stevendiemer/Project-326/README.txt

Hello! 

Thanks for downloading our files! If you have any 
comments or concerns, please let us know by e-mailing 
us at steven.diemer23@gmail.com. 

- Downloading Eagle Schematic and Layout 
	- Say "Open With" 
	- Find Eagle.exe 

Thanks, 

Steven Diemer 
Jordan Visser
