stevendiemer/Project-326/Presentation/Design Review.pptx

## -Design Review- Wave-Motion Arduino Shield

Presented By: Jordan Visser & Steven Diemer
EGR 326: Embedded System Design
Instructor: Andrew Sterian

## Slide 2

Project Summary
Design and Market an Arduino Shield

Project Scope

What is an Arduino?

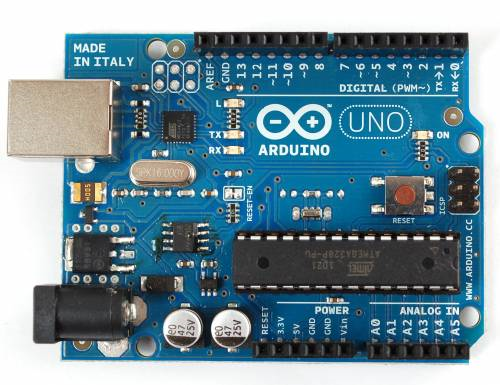
[picture p8: figure]

What is an Arduino Shield?

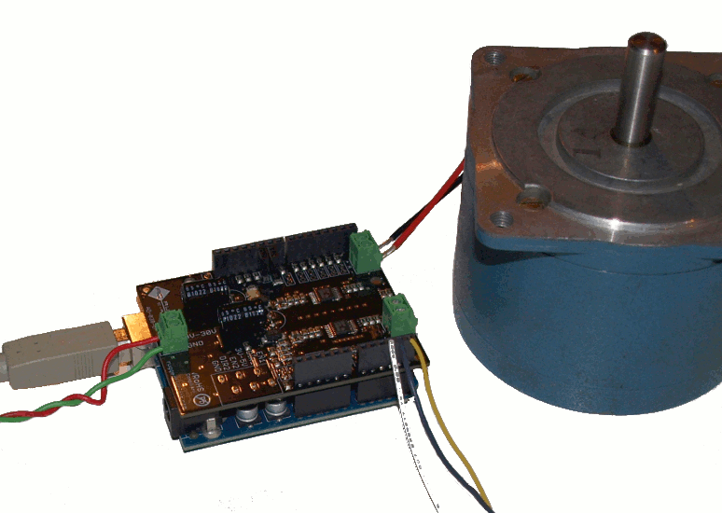
[picture p9: figure]

## Slide 3

Project Motivation

What is it that we are building?

Wanted to build something that…

  - Is fun and also “hackable”/expandable

  - Provided an opportunity to become familiar in many areas we have not previously been exposed to

Why are we building it?

Flash Memory

DAC

Accelerometer

Speaker & Microphone (Audio Capture/Playback)

## Slide 4

Wave-Motion vs. Existing Products

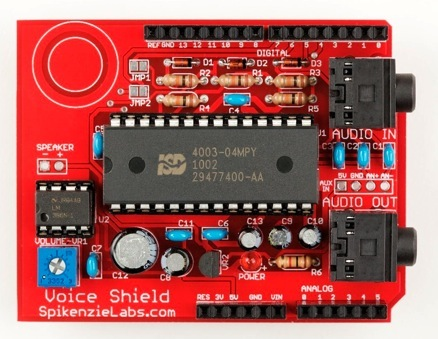
[picture p10: figure]

SpikenzieLabs Voice Shield

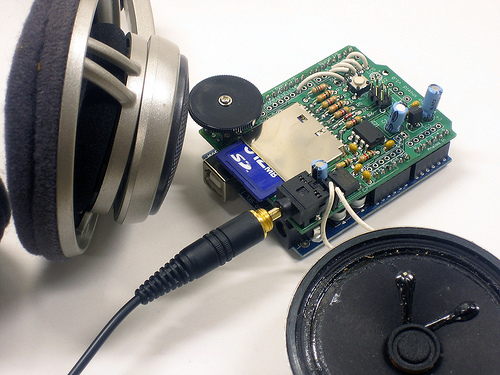
[picture p11: figure]

Ladyada Wave Shield

## Slide 5

Functional Requirements

1. 120 seconds of audio storage at 10-bit 16KHz sampling
rate (minimum)

2) 10-bit 16KHz recording/playback (with no re-sampling)

3) (+/- 8g) 3-Axis Accelerometer Controlled Playback

## Slide 6

Wave-Motion Flow Chart

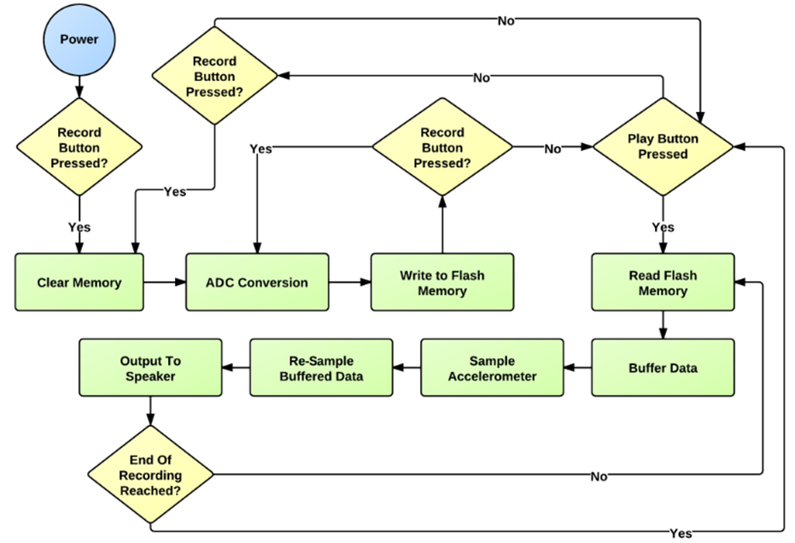
[picture p12: figure]

## Slide 7

Audio Re-Sampling

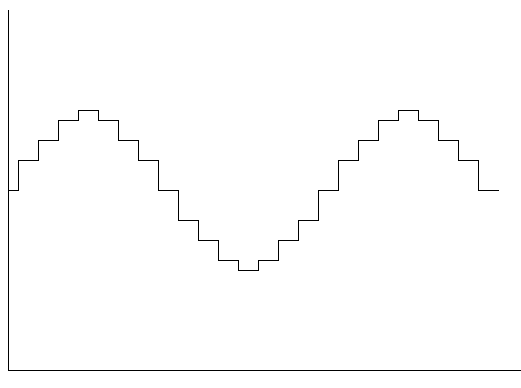
[picture p13: figure]

Native Signal

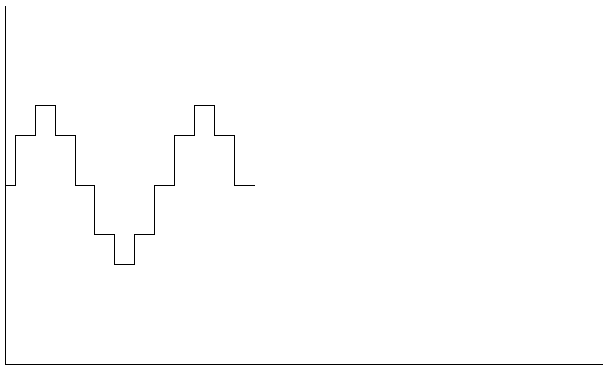
[picture p14: figure]

2x Frequency of Native Signal

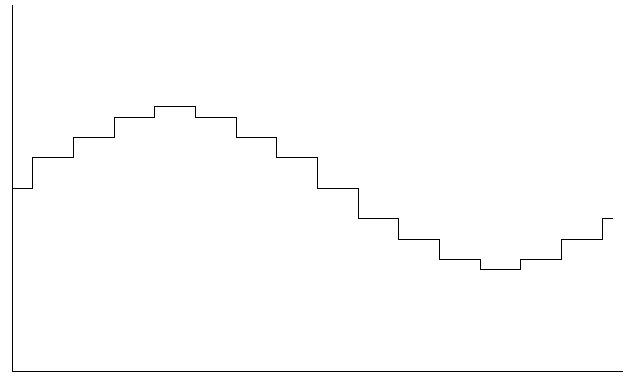
[picture p15: figure]

1/2 Frequency of Native Signal

## Microphone Pre-Amplifier

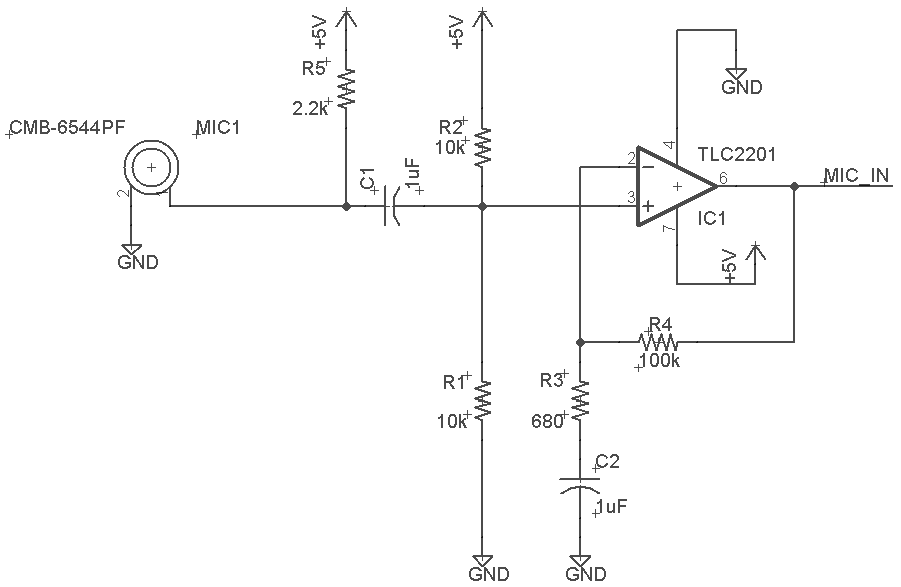
[picture p16: figure]

## 3-Axis Accelerometer

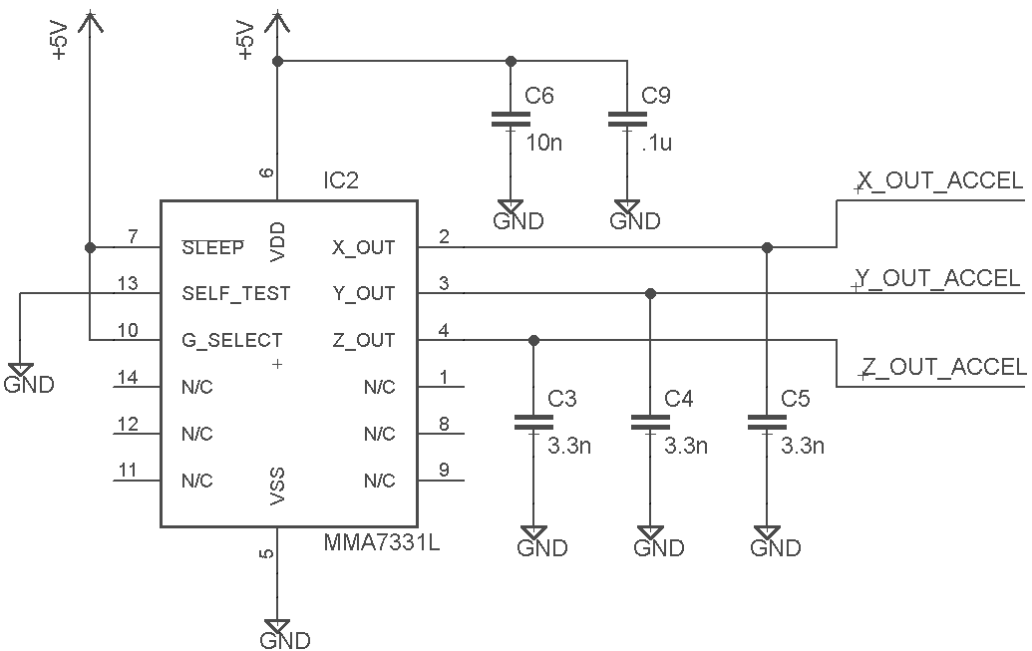
[picture p17: figure]

## Arduino Pin-Out, Switch and Push Buttons

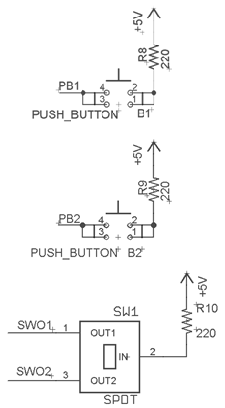
[picture p18: figure]
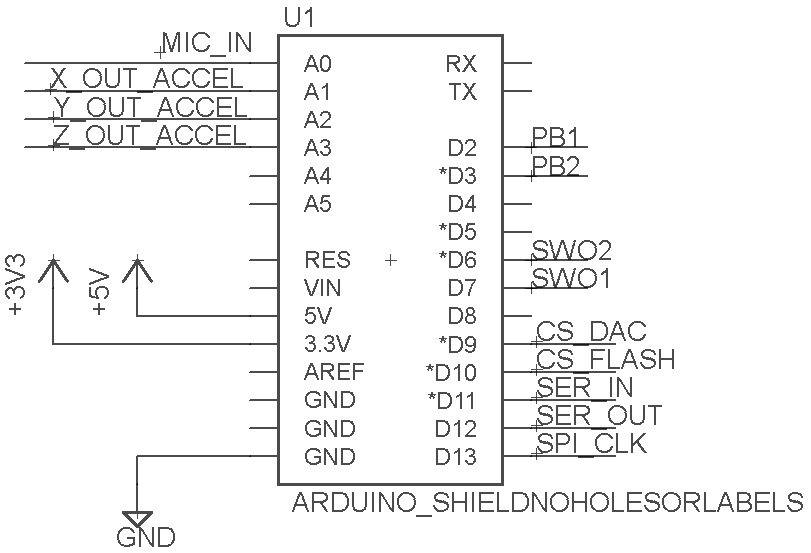
[picture p19: figure]

## Level Shifters and Flash Memory

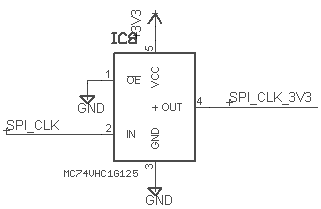
[picture p20: figure]
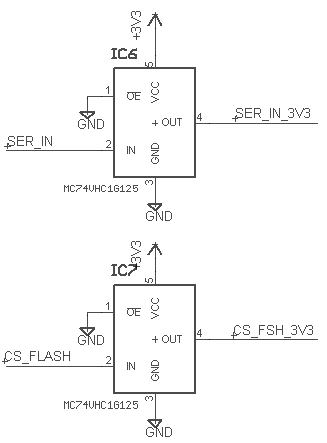
[picture p21: figure]
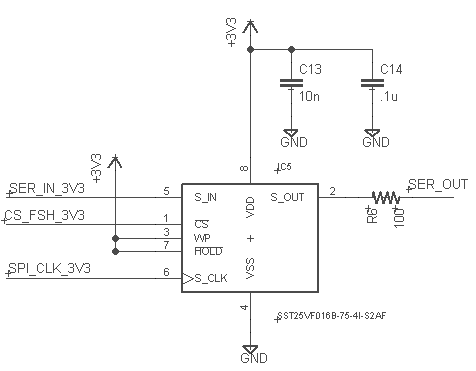
[picture p22: figure]

## Digital-to-Analog Converter

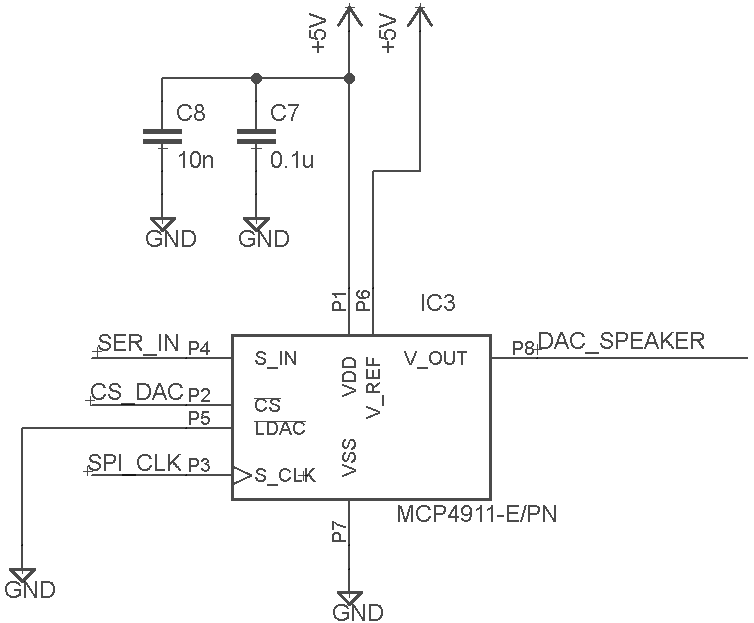
[picture p23: figure]

## Speaker Amplifier

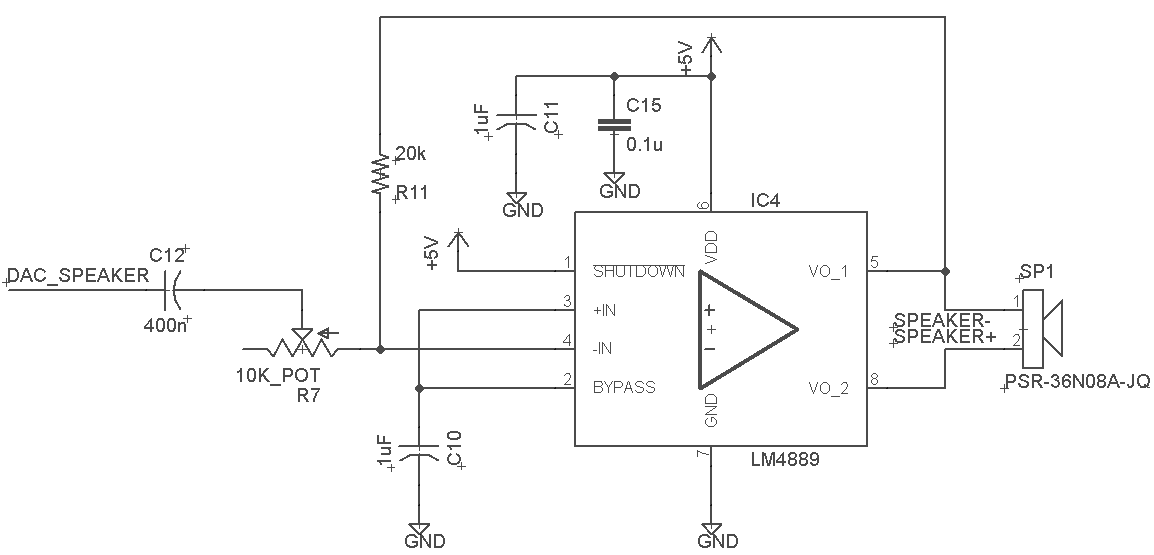
[picture p24: figure]

## Slide 14

Relevant Calculations

Sampling Rate: 73.7 kHz (optimal)

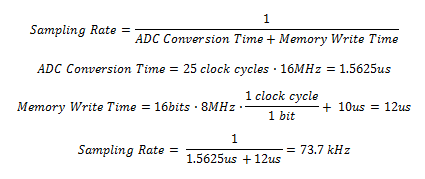
[picture p25: figure]

## Slide 15

Relevant Calculations (Continued)

Playback Rate: 87.0 kHz (optimal)

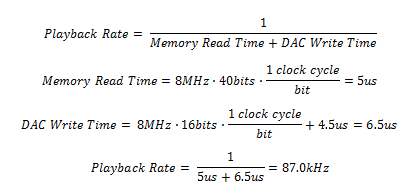
[picture p26: figure]

Record Time: 125 seconds

## Slide 16

We are now open for questions.

- End -

Thank You
