stevendiemer/Project-326/Presentation/Handout.docx

GVSU School of Engineering

EGR326-902 Semester Project

Wave-Motion Arduino Shield

Design Review Supplemental Packet

Presented By:

Jordan Visser

Steven Diemer

Professor: Andrew Sterian

11/4/2011

Bill of Materials:

Microphone Pre-Amplifier:

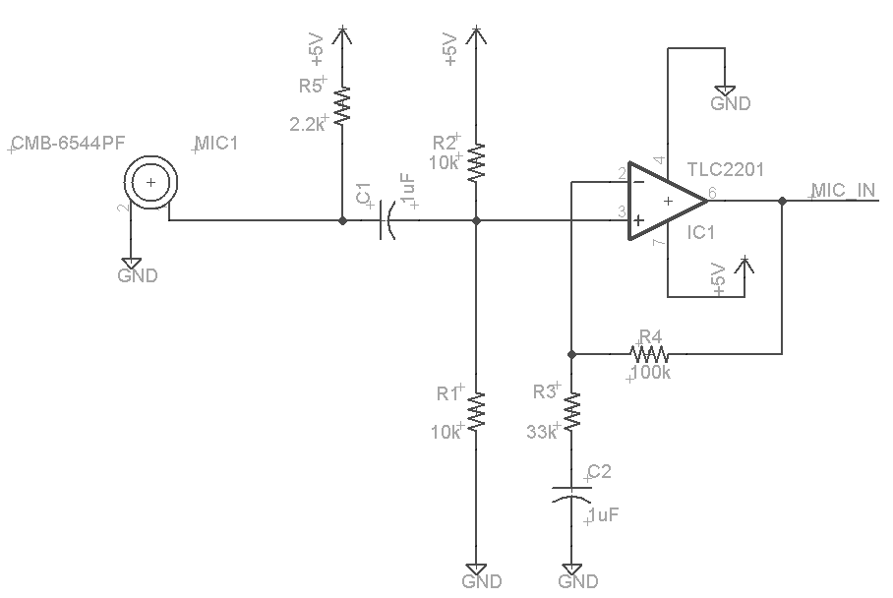
[picture p28: figure]

3-Axis Accelerometer for Re-Sampling Instructions:

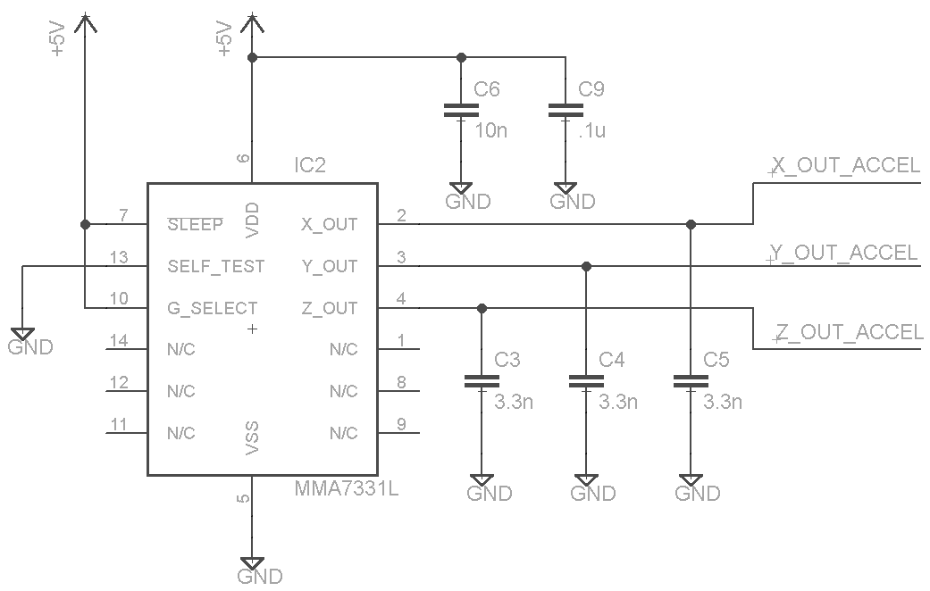
[picture p29: figure]

Arduino Pin Out and Push Buttons and Switch:

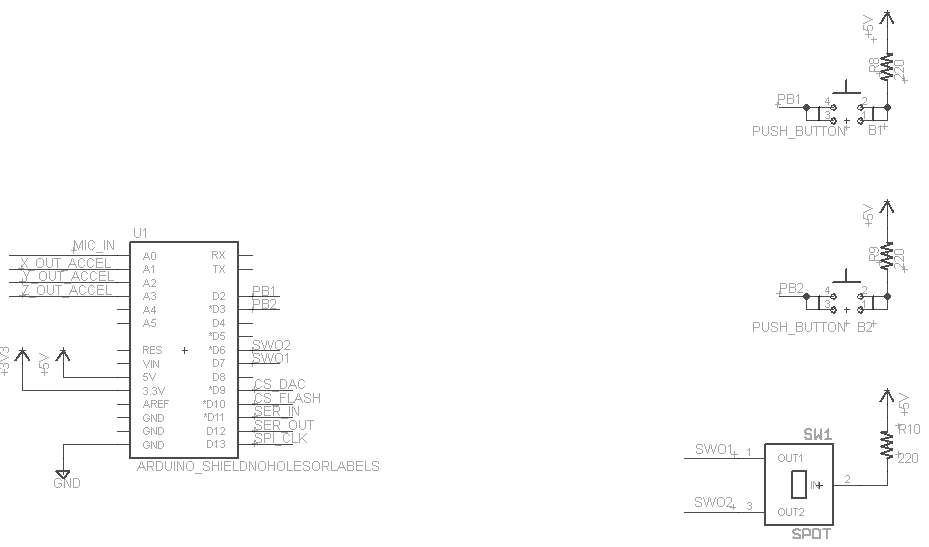
[picture p30: figure]

Level Shifters and Flash Memory:

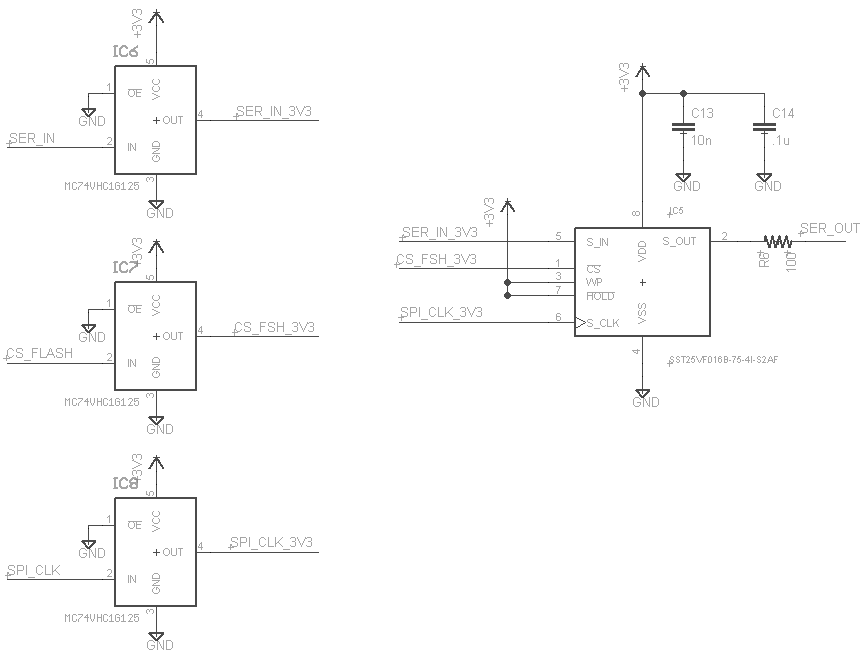
[picture p31: figure]

Digital-to-Analog Converter for Speaker Amplifier Input:

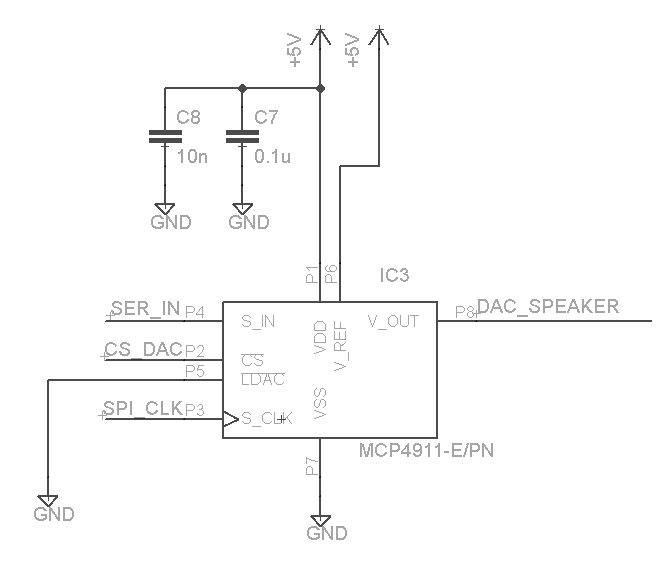
[picture p32: figure]

Speaker Amplifier:

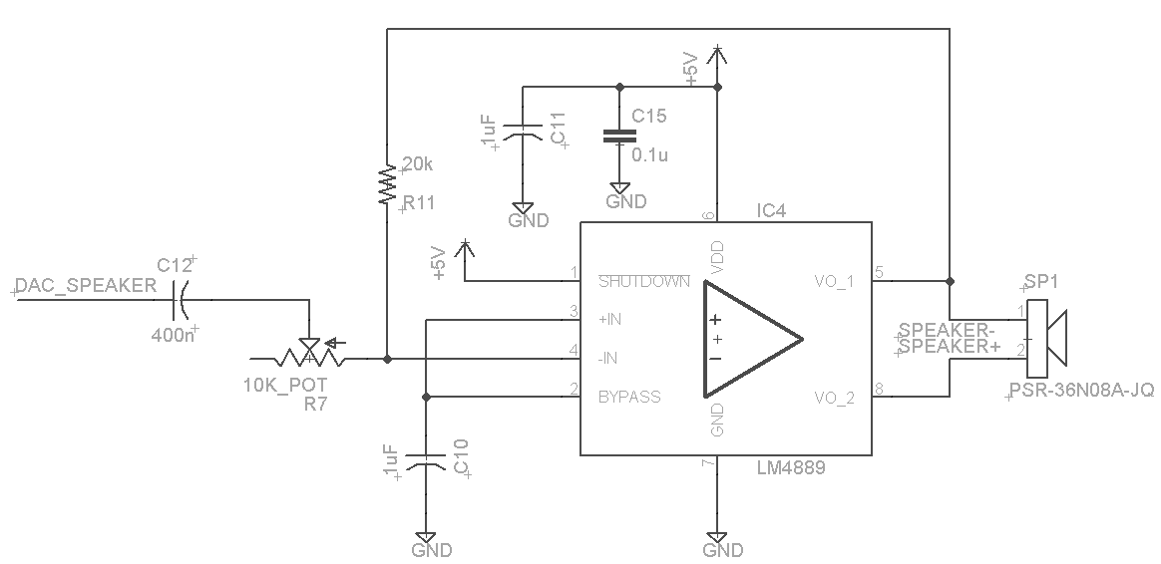
[picture p33: figure]

Software Flow Chart:


Electret Condenser Microphone for Audio Input:

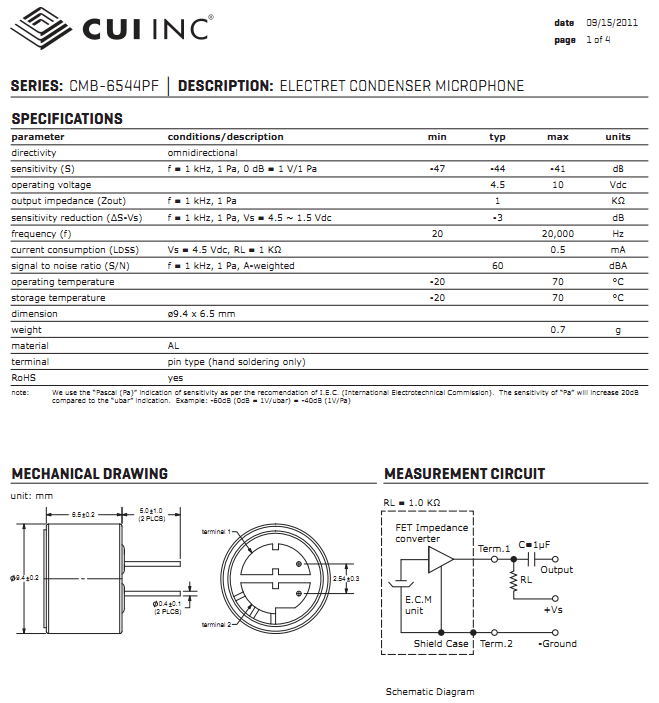
[picture p34: figure]

3-Axis Accelerometer for Re-Sampling Audio:

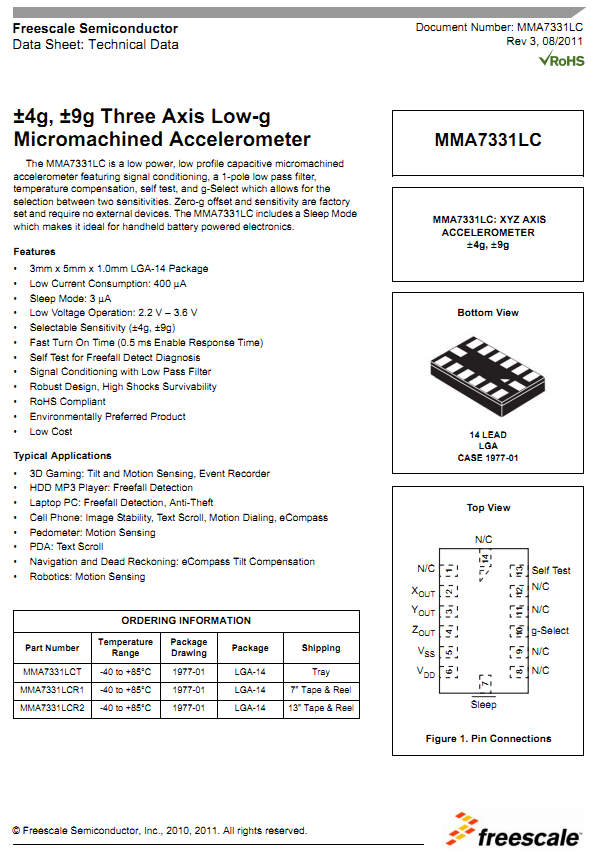
[picture p35: figure]

10-Bit Digital-to-Analog Converter for Speaker:

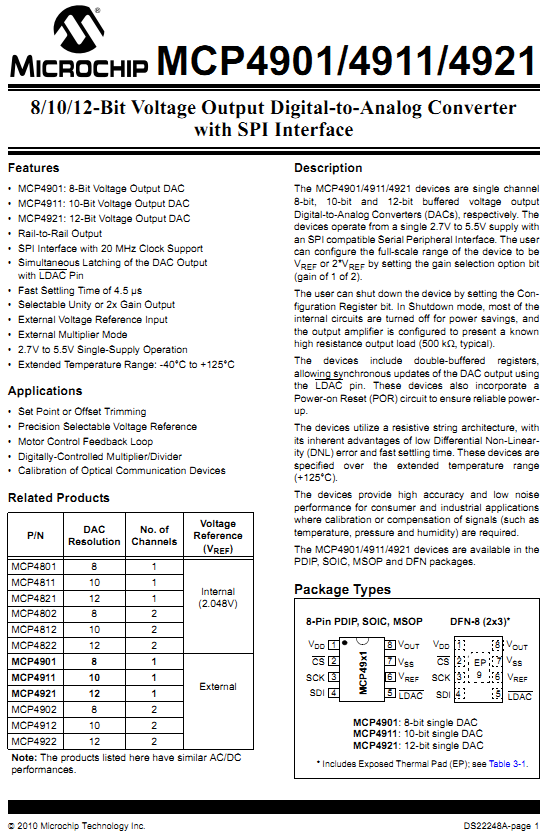
[picture p36: figure]

Audio Power Amplifier for Driving 8Ω Speaker:

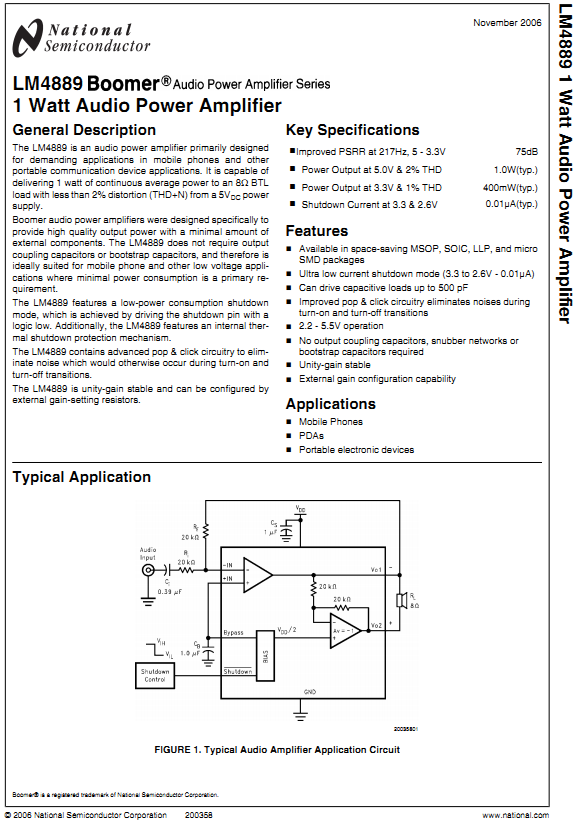
[picture p37: figure]

32Mbit Flash Memory – Page 1:

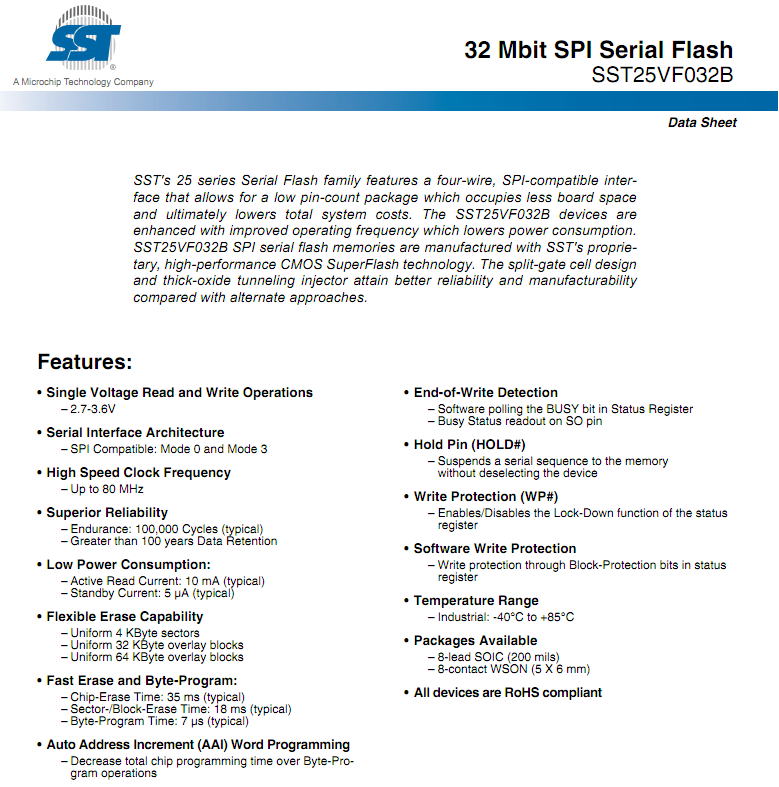
[picture p38: figure]

32Mbit Flash Memory – Page 2:

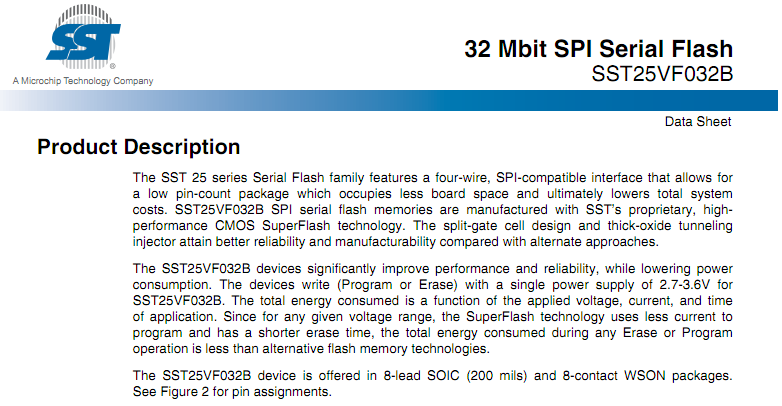
[picture p39: figure]

3.3V Level Shifter for Memory Operation:

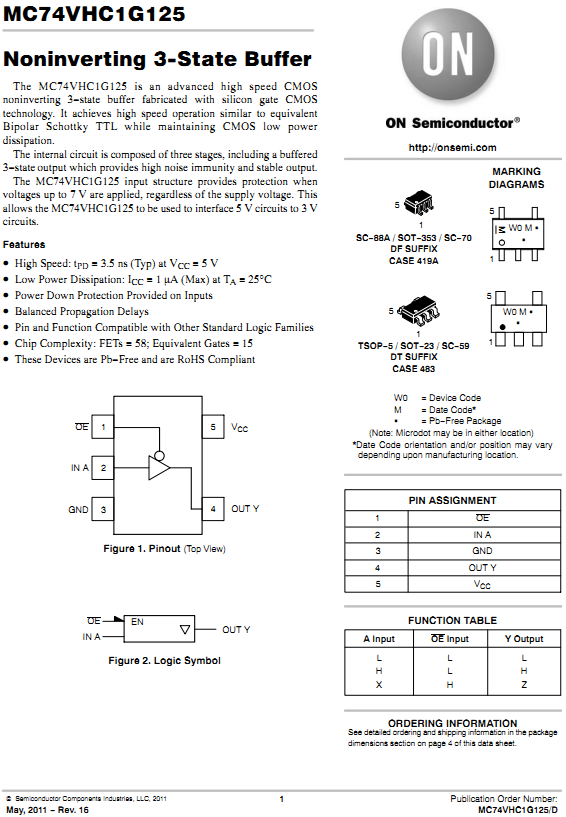
[picture p40: figure]

Push Button for Audio Recording and Playback:

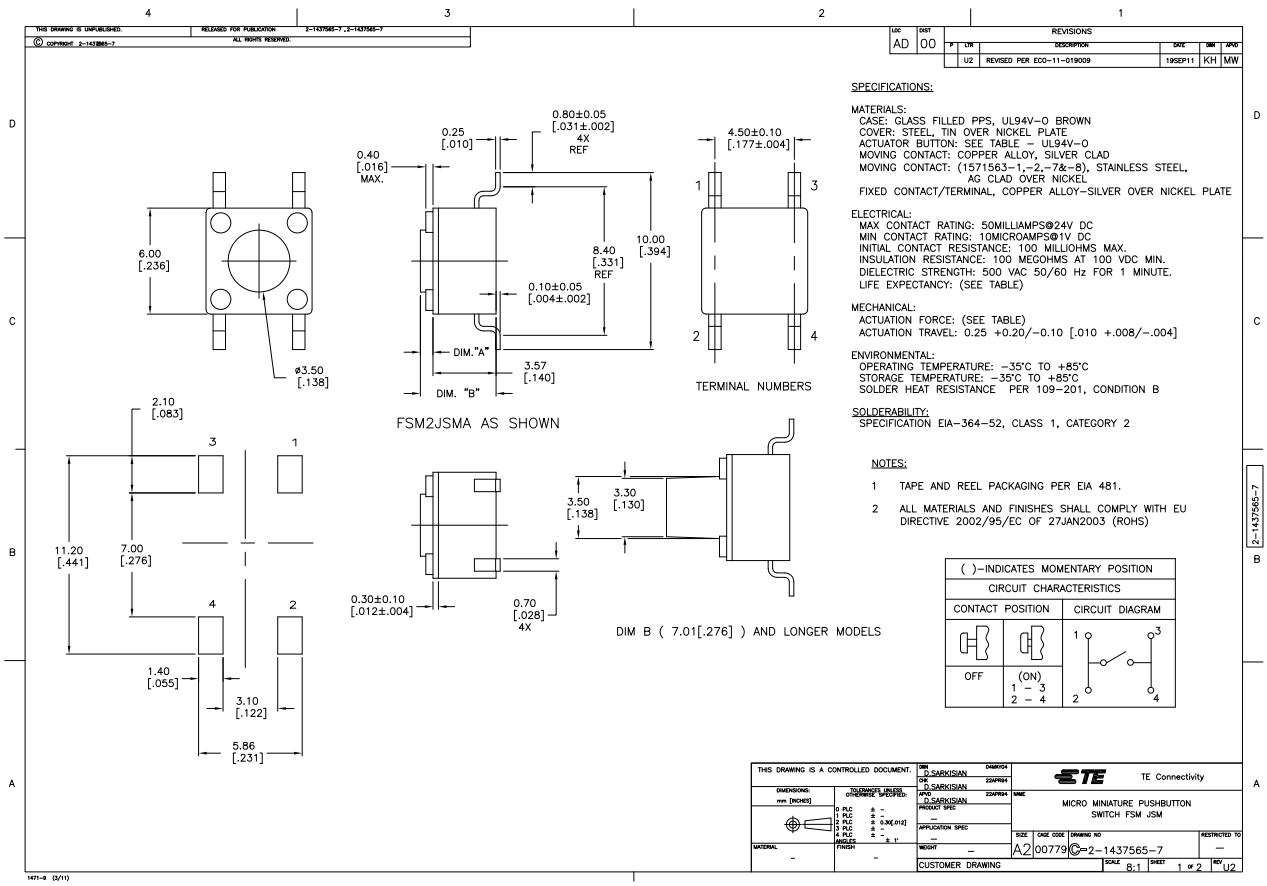
[picture p41: figure]

Single Pull Double Throw Switch for Different Modes of Operation in the Future:

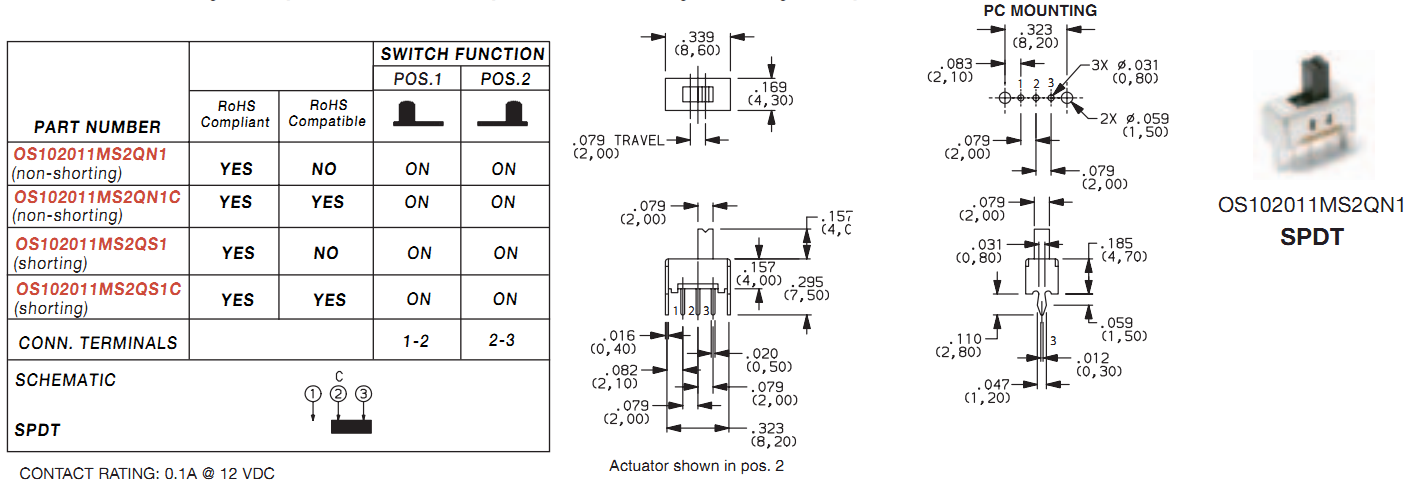
[picture p42: figure]

Sparkfun Connector for Mounting Shield:

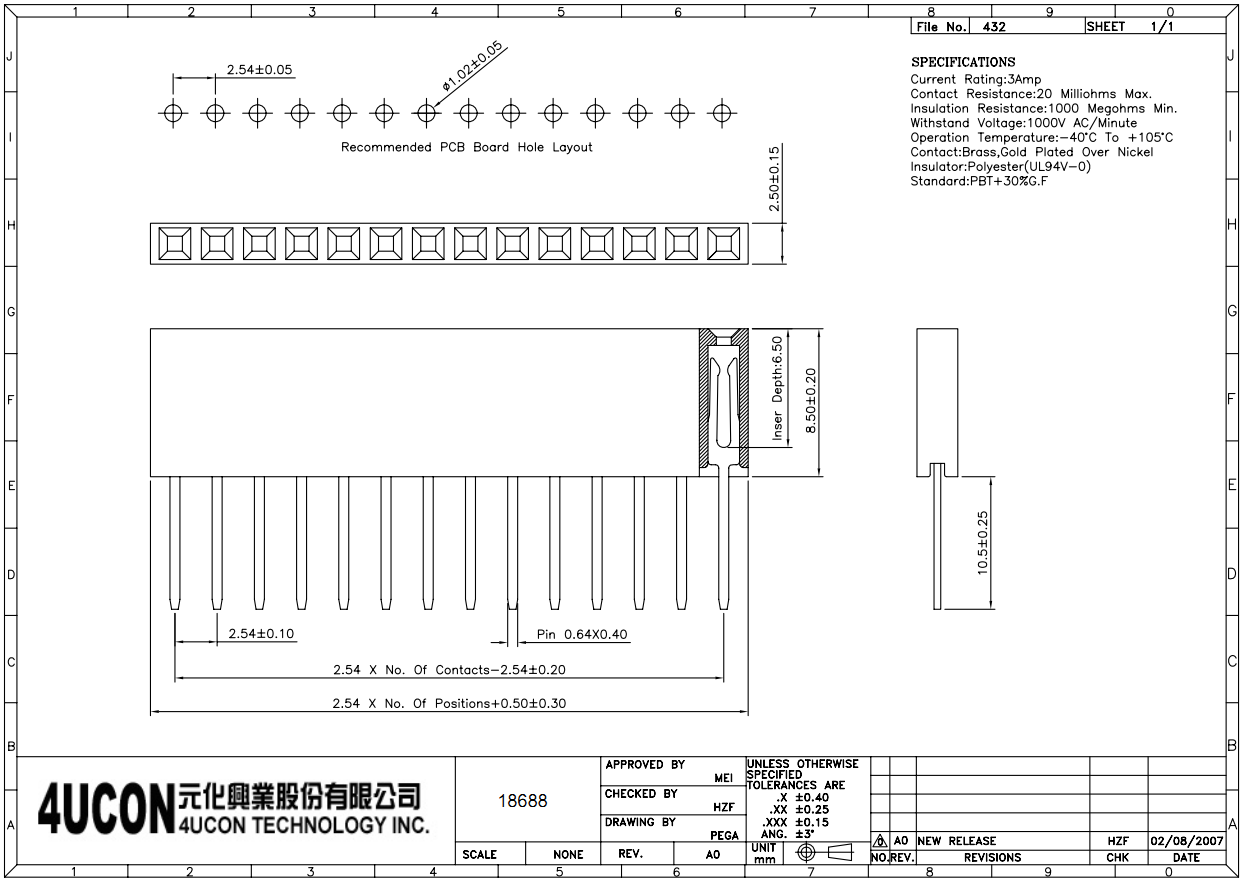
[picture p43: figure]
