stevendiemer/Project-326/BOM/BOM.xlsx

BOM
Description | Manufacturer | Manufacturer PN | Vendor | Vendor PN | Qty. | Package | Cost/Unit ($) | Total ($) | General Note | Datasheet
Rail-to-Rail Op-Amp | Texas Instruments | TLC2201CD | Digi-Key | 296-2425-5-ND | 1 | 8-SOIC | 5.32 | 5.320 | SMD | http://www.ti.com/lit/ds/symlink/tlc2201.pdf
DAC | Microchip Technology | MCP4911-E | Digi-Key | MCP4911-E/SN-ND | 1 | 8-MSOP | 1.66 | 1.660 | - | http://cds.linear.com/docs/Datasheet/1661fa.pdf
3-Axis Accelerometer | Freescale Semiconductor | MMA7331LCT | Digi-Key | MMA7331LCT-ND | 1 | LGA | 2.80 | 2.800 | - | http://cache.freescale.com/files/sensors/doc/data_sheet/MMA7331LC.pdf
Flash Memory (32M) | Microchip Technology | SST25VF032 | Digi-Key | SST25VF032B-80-4I-S2AF-ND | 1 | 8-SOIC | 2.55 | 2.550 | - | http://ww1.microchip.com/downloads/en/DeviceDoc/S71327_04.pdf
0.5W Speaker | Mallory Sonalert | PSR-36N08A-JQ | Digi-Key | 458-1129-ND | 1 | Solder Pads | 1.57 | 1.570 | - | Digikey part (http://search.digikey.com/scripts/DkSearch/dksus.dll?WT.z_header=search_go&lang=en&site=us&x=0&y=0)
Audio Amplifier (1W) | National Semiconductor | LM4889MM/NOPB | Digi-Key | LM4889MMTR-ND | 1 | 8-MSOP | 1.22 | 1.220 | - | http://cache.national.com/ds/LM/LM4889.pdf
Condenser Micrphone | CUI Inc. | CMB-6544PF | Digi-Key | 102-1722-ND | 1 | Solder Posts | 1.04 | 1.040 | - | http://products.cui.com/CUI_CMB-6544PF_Datasheet.pdf?fileID=1544
Pin Connectors | Sparkfun | PRT-10007 | Sparkfun | PRT-10007 | 1 | .1 Inch Pin | 1.5 | 1.500 | - | http://www.sparkfun.com/datasheets/Prototyping/Connectors/18688.pdf
470nF Ceramic | Taiyo Yuden | EMK212B7474KD-T | Digi-Key | 587-1282-1-ND | 1 | 0805 | 0.28 | 0.280 | - | -
1uF Ceramic | Taiyo Yuden | EMK212B7105KG-T | Digi-Key | 587-1283-1-ND | 4 | 0805 | 0.24 | 0.960 | - | -
10nF Ceramic | Johansen Dielectrics Inc | 500R15W103KV4T | Digi-Key | 709-1188-1-ND | 8 | 0805 | 0.044 | 0.352 | Min Qty. of 10 | -
100nF Ceramic | Yageo | CC0805KRX7R9BB104 | Digi-Key | 311-1140-1-ND | 8 | 0805 | 0.063 | 0.504 | Min Qty. of 10 | -
3.3nF Ceramic | AVX Corporation | 08051C332KAT2A | Digi-Key | 478-1355-1-ND | 3 | 0805 | 0.24 | 0.720 | - | -
Push Button | TE Connectivity | FSM4JSMATR | Digi-Key | 450-1759-1-ND | 2 | SMD | 0.35 | 0.700 | - | SPST Push Button (http://media.digikey.com/pdf/Data%20Sheets/Tyco%20Electronics%20Alcoswitch%20PDFs/FSM%20Series.pdf)
SPDT Switch | C&K Components | OS102011MS2QN1 | Digi-Key | CKN9565-ND | 1 | Through Hole | 0.52 | 0.520 | - | SPDT Switch (http://www.ck-components.com/index.php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)
3.3V Level Shifter | ON Semiconductor | M74VHC1G125DTT1G | Digi-Key | M74VHC1G125DTT1GOSCT-ND | 3 | SOT-23-5 | 0.44 | 1.320 | - | http://www.onsemi.com/pub_link/Collateral/MC74VHC1G125-D.PDF
2.2 kΩ Chip Resistor | Stackpole Electronics | RMCF0805JT2K20 | Digi-Key | RMCF0805JT2K20CT-ND | 1 | 0805 | 0.03 | 0.03 | - | http://www.seielect.com/Catalog/SEI-RMCF.pdf
10 kΩ Chip Resistor | Stackpole Electronics | RMCF0805JT10K0 | Digi-Key | RMCF0805JT10K0CT-ND | 3 | 0805 | 0.03 | 0.09 | - | http://www.seielect.com/Catalog/SEI-RMCF.pdf
100 kΩ Chip Resistor | Stackpole Electronics | RMCF0805JT100K | Digi-Key | RMCF0805JT100KCT-ND | 1 | 0805 | 0.03 | 0.03 | - | http://www.seielect.com/Catalog/SEI-RMCF.pdf
100 Ω Chip Resistor | Stackpole Electronics | RMCF0805JT100R | Digi-Key | RMCF0805JT100RCT-ND | 1 | 0805 | 0.03 | 0.03 | - | http://www.seielect.com/Catalog/SEI-RMCF.pdf
20 kΩ Chip Resistor | Stackpole Electronics | RMCF0805JT20K0 | Digi-Key | RMCF0805JT20K0CT-ND | 1 | 0805 | 0.03 | 0.03 | - | http://www.seielect.com/Catalog/SEI-RMCF.pdf
10 kΩ Potentiometer | Bourns Inc. | 3352T-1-103LF | Digi-Key | 3352T-103LF-ND | 1 | Through Hole | 1.58 | 1.58 | - | http://www.bourns.com/data/global/PDFs/3352.pdf
Rail-to-Rail Op-Amp | Microchip Technology | MCP6L1RT-E/OTCT-ND | Digi-Key | MCP6L1RT-E/OT | 1 | SOT-23-5 | 0.45 | 0.450 | - | http://ww1.microchip.com/downloads/en/DeviceDoc/22135B.pdf
 |  |  |  |  |  | Total Cost/Board |  | 24.806
