stevendiemer/Project-326/(commit log)

2011-11-03 Added Eagle Files for Download!
    [Wave Motion.brd, Wave Motion.sch]
2011-11-04 Updated Schematic and layout to correct error.
    [Wave Motion.brd, Wave Motion.sch]
2011-11-04 Added Datasheets, updated schematic, and presentation handouts
    [BOM.xlsx, Wave Motion.sch]
2011-11-04 PowerPoint added for Presentation
2011-11-04 updated flowchart
2011-11-09 Updated to new Board Layout and Schematic
    [BOM.xlsx, Wave Motion.brd, Wave Motion.sch]
2011-11-11 Final Board Layout and Files
    [BOM.xlsx, Wave Motion.brd, Wave Motion.sch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]
2011-11-11 Adding new Board Layout Files and Updated BOM
    [BOM.xlsx, Wave Motion.brd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]
2011-11-18 Updated to latest files
    [BOM.xlsx, Wave Motion.brd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]
2011-11-18 Fixed error in schematic and board layout and updated files to latest version
    [Wave Motion.brd, Wave Motion.sch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]
2011-12-07 Added First Release of Code for Basic Functionality of the Wave-Motion Board
2011-12-12 Updated board, schematic, and GERBER files to correct silkscreen error on shield
    [Wave Motion.brd, Wave Motion.sch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]
2012-03-08 backup files for Project 2
    [maze_that_pays.sch]
2012-03-10 code for win and loss added
    [maze_that_pays.sch]
2012-03-13 working copy 1.0 for project 2
    [maze_that_pays.sch]
2012-03-13 Version 2.0 of files with timer displayed
2012-03-13 added updated files
    [maze_that_pays.sch]
2012-03-19 starting files for project 3
    [toplevel.sch]
2012-03-22 BCD Working
    [toplevel.sch]
